MengYang-x/CradleFOC/2.软件设计手册/2.Test/4.key_test/README.md

# STM32CubeMX配置

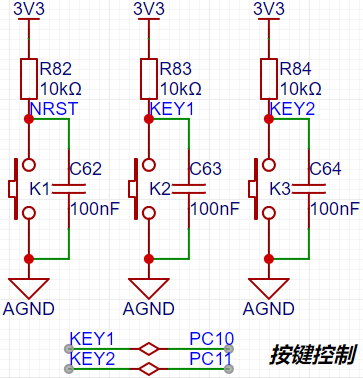
[picture p21: 2.软件设计手册/1.pictures/按键控制电路.png]
    

- 按键未按下时：高电平
- 使用外部中断检测按键的状态，下降沿触发外部中断。

   

 

# HAL

```C
#include "main.h"

// 自定义us延时函数
void delay_us(uint32_t us)
{
    uint32_t delay = (HAL_RCC_GetHCLKFreq() / 24000000 * us); // 数值与选用的晶振有关，24MHz无源晶振
    while (delay--)
        ; // 循环delay次，达到1us延时
}

// 按键扫描函数
uint8_t key_scan(GPIO_TypeDef *GPIOx, uint16_t GPIO_Pin)
{
    uint8_t flag = 0;      // 按键未按下
    uint16_t time = 30000; // 按键消抖时间，30ms
    if (HAL_GPIO_ReadPin(GPIOx, GPIO_Pin) == 0)
    {
        delay_us(time);
        if (HAL_GPIO_ReadPin(GPIOx, GPIO_Pin) == 0)
        {
            flag = 1; // 确定按键被按下
        }
    }
    while (HAL_GPIO_ReadPin(GPIOx, GPIO_Pin) == 0)
        ; // 等待按键松开
    delay_us(time);
    return flag;
}

/**
 * @brief  EXTI line detection callback.
 * @param  GPIO_Pin: Specifies the port pin connected to corresponding EXTI line.
 * @retval None
 */
void HAL_GPIO_EXTI_Callback(uint16_t GPIO_Pin)
{
    /* Prevent unused argument(s) compilation warning */
    UNUSED(GPIO_Pin);

    // 中断源判断
    switch (GPIO_Pin) // PC15 ，抢占优先级0，响应优先级0
    {
    case KEY1_Pin:
        if (key_scan(KEY1_GPIO_Port, KEY1_Pin))
        {
            HAL_GPIO_TogglePin(LED1_GPIO_Port, LED1_Pin);
        }
        break;
    case KEY2_Pin:
        if (key_scan(KEY2_GPIO_Port, KEY2_Pin))
        {
            HAL_GPIO_TogglePin(LED2_GPIO_Port, LED2_Pin);
        }
        break;

    default:
        break;
    }
}
```
