MengYang-x/CradleFOC/2.软件设计手册/2.Test/6.ADC_test/CradleFOC_os/CradleFOC_os.ioc

Mcu.UserName=STM32G431CBUx
PA0.GPIO_Label=POT
PA0.Signal=ADC1_IN1
PA1.Signal=OPAMP1_VINP
PA10.Signal=S_TIM1_CH3
PA13.Signal=SYS_JTMS-SWDIO
PA14.Signal=SYS_JTCK-SWCLK
PA2.Signal=SharedAnalog_PA2
PA3.Signal=OPAMP1_VINM
PA4.GPIO_Label=MB
PA4.Signal=ADC2_IN17
PA5.Signal=OPAMP2_VINM
PA6.Signal=SharedAnalog_PA6
PA7.Signal=OPAMP2_VINP
PA8.Signal=S_TIM1_CH1
PA9.Signal=S_TIM1_CH2
PB0.Signal=OPAMP3_VINP
PB1.Signal=SharedAnalog_PB1
PB10.Signal=OPAMP3_VINM
PB11.GPIO_Label=MA
PB11.Signal=ADC1_IN14
PB12.GPIO_Label=MC
PB12.Signal=ADC1_IN11
PB2.GPIO_Label=NTC
PB2.Signal=ADC2_IN12
PB3.GPIO_Label=MT6701_SCL
PB3.Signal=SPI1_SCK
PB4.GPIO_Label=MT6701_SDA
PB4.Signal=SPI1_MISO
PB6.Signal=USART1_TX
PB7.Signal=USART1_RX
PB9.GPIO_Label=MT6701_CS
PB9.Signal=GPIO_Output
PC10.GPIO_Label=KEY1
PC10.Signal=GPXTI10
PC11.GPIO_Label=KEY2
PC11.Signal=GPXTI11
PC14-OSC32_IN.GPIO_Label=LED1
PC14-OSC32_IN.Signal=GPIO_Output
PC15-OSC32_OUT.GPIO_Label=LED2
PC15-OSC32_OUT.Signal=GPIO_Output
PC4.GPIO_Label=Udc
PC4.Signal=ADC2_IN5
PF0-OSC_IN.Signal=RCC_OSC_IN
PF1-OSC_OUT.Signal=RCC_OSC_OUT
