MengYang-x/CradleFOC/2.软件设计手册/2.Test/6.ADC_test/CradleFOC_os/Core/Inc/main.h

#define LED1_Pin GPIO_PIN_14
#define LED1_GPIO_Port GPIOC
#define LED2_Pin GPIO_PIN_15
#define LED2_GPIO_Port GPIOC
#define POT_Pin GPIO_PIN_0
#define POT_GPIO_Port GPIOA
#define MB_Pin GPIO_PIN_4
#define MB_GPIO_Port GPIOA
#define Udc_Pin GPIO_PIN_4
#define Udc_GPIO_Port GPIOC
#define NTC_Pin GPIO_PIN_2
#define NTC_GPIO_Port GPIOB
#define MA_Pin GPIO_PIN_11
#define MA_GPIO_Port GPIOB
#define MC_Pin GPIO_PIN_12
#define MC_GPIO_Port GPIOB
#define KEY1_Pin GPIO_PIN_10
#define KEY1_GPIO_Port GPIOC
#define KEY1_EXTI_IRQn EXTI15_10_IRQn
#define KEY2_Pin GPIO_PIN_11
#define KEY2_GPIO_Port GPIOC
#define KEY2_EXTI_IRQn EXTI15_10_IRQn
#define MT6701_SCL_Pin GPIO_PIN_3
#define MT6701_SCL_GPIO_Port GPIOB
#define MT6701_SDA_Pin GPIO_PIN_4
#define MT6701_SDA_GPIO_Port GPIOB
#define MT6701_CS_Pin GPIO_PIN_9
#define MT6701_CS_GPIO_Port GPIOB
