MengYang-x/CradleFOC/2.软件设计手册/2.Test/6.ADC_test/CradleFOC_os/MT6701/MT6701.h

//
// Created by User on 2024/5/3.
//

#ifndef CRADLEFOC_OS_MT6701_H
#define CRADLEFOC_OS_MT6701_H

#include "stdint.h"

class MT6701 {
private:
    uint64_t angle_prev_ts;
    uint64_t vel_angle_prev_ts;
    int rotationCount; // 转过的圈数
    int rotationCount_last;
    float angle_last; // 上一时刻的机械角度
    float full_angle; // 转过的总角度
    float full_angle_last;
public:

    float GetRawAngle();

    float GetFullAngle();

    float GetElAngle();

    float GetVelocity();
};

extern MT6701 mt6701;

#endif //CRADLEFOC_OS_MT6701_H
