MengYang-x/CradleFOC/2.软件设计手册/2.Test/6.ADC_test/CradleFOC_os/UserAPP/UserAPP.h

//
// Created by User on 2024/5/3.
//

#ifndef CRADLEFOC_OS_USERAPP_H
#define CRADLEFOC_OS_USERAPP_H

#ifdef __cplusplus
extern "C" {
#endif
/**********包含C的H文件**************/


/**********C++文件中的函数声明**************/
void setup();
void task_log();
void task_key();
void task_FOC();

#ifdef __cplusplus
}
/**********包含C++的H文件**************/


#endif

#endif //CRADLEFOC_OS_USERAPP_H
