MengYang-x/CradleFOC/(commit log)

2024-03-24 电机选型
2024-03-24 修改图片大小
2024-03-24 更改电机的参数，电机收到货之后开始进行编码器底板的设计
2024-03-25 去实验室备份
2024-03-27 去实验室前备份
2024-03-27 引脚分配
2024-03-28 内部OPA与ADC级联配置
2024-03-28 邮箱更改
2024-03-28 GPIO分配
2024-04-01 PCB设计完成
2024-04-07 CradleFOC实物焊接测试完毕
2024-04-07 LED功能测试完毕
2024-04-08 UART的LL库程序DMA发送暂有问题未解决
2024-04-09 MT6701编码器功能测试完成
2024-04-11 按键测试
2024-04-29 使用C++开发项目
    [stlink.cfg]
2024-04-29 MT6701程序优化
2024-04-29 添加DSP库
2024-05-01 开环测试完成
2024-05-01 开环测试
2024-05-03 引入FreeRTOS
    [stlink.cfg]
2024-05-03 开环完成
2024-05-04 定时器触发ADC规则组多通道DMA
2024-05-04 ADC测试程序编写完成
