MengYang-x/CradleFOC/(notices)

Notices in the files:
2.软件设计手册/2.Test/6.ADC_test/CradleFOC_os/Core/Inc/main.h:
Copyright (c) 2024 STMicroelectronics.
All rights reserved.
This software is licensed under terms that can be found in the LICENSE file
